jttaufa/Rattus2/BillOfMaterials.xlsx

Sheet: Prototype 1
 | METR4901 - Thesis Project
Line | Description | Qty Reqd | Supplier | Supplier Part # | Weight (g) | Order Qty | Unit Price | Currency | Total Price | Total Price (AUD) | Supplier URL
1 | 50:1 Micro Metal Gearmotor HP with Extended Motor Shaft | 2 | Littlebird | 2213 | 19 | 2 | $18.87 | AUD | $37.74 | $37.74 | http://littlebirdelectronics.com.au/products/501-micro-metal-gearmotor-hp-with-extended-motor-shaft
2 | Optical Encoder Pair Kit for Micro Metal Gearmotors, 5V | 1 | Littlebird | 2590 | 0.7 | 1 | $10.20 | AUD | $10.20 | $10.20 | http://littlebirdelectronics.com.au/products/optical-encoder-pair-kit-for-micro-metal-gearmotors-5v
3 | TB6612FNG Dual Motor Driver Carrier | 1 | Littlebird | 713 | 5 | 1 | $5.45 | AUD | $5.45 | $5.45 | http://littlebirdelectronics.com.au/products/tb6612fng-dual-motor-driver-carrier
4 | Pololu Micro Metal Gearmotor Bracket Pair - Black | 1 | Littlebird | 989 | 1.4 | 1 | $5.68 | AUD | $5.68 | $5.68 | https://www.pololu.com/product/989/specs
5 | Power HD Micro Servo HD-1900A | 1 | Littlebird | 1050 | 9 | 1 | $7.65 | AUD | $7.65 | $7.65 | http://littlebirdelectronics.com.au/products/power-hd-micro-servo-hd-1900a
6 | Arduino Micro | 1 | Pololu | 2188 | 13 | 1 | $24.95 | USD | $24.95 | $32.19 | https://www.pololu.com/product/2188
7 | Pololu Ball Caster with 1/2" Metal Ball | 1 | Pololu | 953 | 9.07 | 1 | $1.99 | USD | $1.99 | $2.57 | https://www.pololu.com/product/953
8 | Cable/Ribbon/Standard/Color Coded/10-Way | 1 | ETSG | 22-05-01' | ? | 1 | $3.35 | AUD | $3.35 | $3.35
9 | Infrared Proximity Sensor Short Range - Sharp GP2Y0A41SK0F | 2 | Pololu | 2464 | 7.2 | 2 | $10.51 | USD | $21.02 | $27.12 | https://www.pololu.com/product/2464
10 | Li-Ion 18650 Battery 7.4V, 2.6Ah LC-18650S2WR-2600 | 1 | BatterySpace | 4742 | 130 | 1 | $30.95 | USD | $30.95 | $39.93 | http://www.batteryspace.com/li-ion18650battery74v2600mah1924whbatterypackmodulewithpcbprotectionic.aspx
11 | Smart Charger (1.2A) for 7.4V Li-Ion/Polymer Rechargeable Battery Pack CH-L7412 | 1 | BatterySpace | 4208 | - | 1 | $22.95 | USD | $22.95 | $29.61 | http://www.batteryspace.com/smartcharger12afor74vli-ionpolymerrechargeablebatterypack--ullisted.aspx
12 | USR WIFI232 T Serial to Wifi Module UART to Wifi Support WPS Smart LINK | 1 | Amazon.com | - | ? | 1 | $12.76 | USD | $12.76 | $16.46 | http://www.amazon.com/Usr-wifi232-t-Power-802-11b-Price-Module/dp/B00ODV2OEW?s=pc
13 | Pololu Wheel 60x8mm Pair - Black | 1 | Pololu | 1420 | 22.68 | 1 | $7.95 | USD | $7.95 | $10.26 | https://www.pololu.com/product/1420/specs
14 | DE-SWADJ3 Adjustable Switching Voltage Regulator | 1 | RobotShop | RB-Dim-14 | 10 | 1 | $14.99 | USD | $14.99 | $19.34 | http://www.robotshop.com/en/dimension-engineering-de-swadj.html
15 | 3D Printed Material |  |  |  | - | Cost/gram -> | $0.03 | USD | $1.83 | $2.36 | http://www.dfrobot.com/index.php?route=product/product&product_id=906#.VX4BaUYnKjM
 |  |  |  | Total Upper Electronics Weight | 35.2 |  |  |  | Total (AUD) | $228.19
 |  |  |  | Total Lower Electronics Weight | 191.85
 |  |  |  | Top Platform | 20 |  |  |  | Total Weight (g) | 304
 |  |  |  | Base Platform | 28 |  |  |  | Length (mm) | 180
 |  |  |  | Motor Enclosure | 7 |  |  |  | Width (mm) | 100
 |  |  |  | Component Clip | 9 |  |  |  | Height (mm) | 75
 |  |  |  | Housing | 13

Sheet: Prototype 2
 | METR4901 - Thesis Project
Line | Description | Qty Reqd | Supplier | Supplier Part # | Weight (g) | Order Qty | Unit Price | Currency | Total Price | Total Price (AUD) | Supplier URL
1 | Connector: JST PH - Crimp Terminal Housing/ 04 Wa/ 2.00mm pitch | 2 | ETSG | 08-49-02 |  | 2 | $0.07 | AUD | $0.14 | $0.14
2 | Connector: JST PH - Crimp Terminal/Use Crimp tool K143 | 14 | ETSG | 08-50-03 |  | 14 | $0.02 | AUD | $0.28 | $0.28
3 | Connector: JST PH- Top Entry Header/ SMD/04 Way/ 2mm pitch | 2 | ETSG | 08-54-02 |  | 2 | $1.71 | AUD | $3.42 | $3.42
4 | Cables & Accessories: cable/Ribbon/standard/colour coded/10Way | 1 | ETSG | 22-05-01 |  | 1 | $3.35 | AUD | $3.35 | $3.35
5 | Connector: IDC - 06 Way female/ Class III/With Strain Relief/Harting | 2 | ETSG | 01-67-01 |  | 2 | $1.500 | AUD | $3.00 | $3.00
6 | Connector: DC power socket - 2.1mm/PCB Mounted | 1 | ETSG | 03-71-03 |  | 1 | $1.10 | AUD | $1.10 | $1.10
7 | Capacitor: Ceramic/0603/10000/10n/50V/X7R | 10 | ETSG | 64-12-01 |  | 10 | $0.01 | AUD | $0.10 | $0.10
8 | Capacitor: Ceramic/0603/100000/100n/50V/X7R | 20 | ETSG | 64-13-01 |  | 20 | $0.03 | AUD | $0.60 | $0.60
9 | Capacitor: Ceramic/0603/6800/6n8/50V/X7R | 6 | ETSG | 64-11-11 |  | 6 | $0.01 | AUD | $0.06 | $0.06
10 | Capacitor:Ceramic/0603/470000/470n/50V/X7R | 5 | ETSG | 64-13-09 |  | 5 | $0.12 | AUD | $0.60 | $0.60
11 | Resistor: 0603/100K | 6 | ETSG | 61-20-02 |  | 6 | $0.06 | AUD | $0.36 | $0.36
12 | Resistor: 0603/147K | 6 | ETSG | 61-19-06 |  | 6 | $0.06 | AUD | $0.36 | $0.36
18 | Cable/Ribbon/Standard/Color Coded/10-Way | 1 | ETSG | 22-05-01' |  | 1 | $3.35 | AUD | $3.35 | $3.35
13 | 50:1 Micro Metal Gearmotor HP with Extended Motor Shaft | 2 | Littlebird | 2213 | 9.5 | 2 | $18.87 | AUD | $37.74 | $37.74 | http://littlebirdelectronics.com.au/products/501-micro-metal-gearmotor-hp-with-extended-motor-shaft
14 | Optical Encoder Pair Kit for Micro Metal Gearmotors, 5V | 1 | Littlebird | 2590 | 0.7 | 1 | $10.20 | AUD | $10.20 | $10.20 | http://littlebirdelectronics.com.au/products/optical-encoder-pair-kit-for-micro-metal-gearmotors-5v
15 | Pololu Micro Metal Gearmotor Bracket Pair - Black | 1 | Littlebird | 989 | 1.4 | 1 | $5.68 | AUD | $5.68 | $5.68 | https://www.pololu.com/product/989/specs
16 | Power HD Micro Servo HD-1900A | 1 | Littlebird | 1050 | 9 | 1 | $7.65 | AUD | $7.65 | $7.65 | http://littlebirdelectronics.com.au/products/power-hd-micro-servo-hd-1900a
17 | Pololu Ball Caster with 1/2" Metal Ball | 1 | Pololu | 953 | 9.07 | 1 | $1.99 | USD | $1.99 | $2.57 | https://www.pololu.com/product/953
19 | Infrared Proximity Sensor Short Range - Sharp GP2Y0A41SK0F | 2 | Pololu | 2464 | 3.6 | 2 | $10.51 | AUD | $21.02 | $21.02 | https://www.pololu.com/product/2464
20 | Li-Ion 18650 Battery 7.4V, 2.6Ah LC-18650S2WR-2600 | 1 | BatterySpace | 4742 | 130 | 1 | $30.95 | USD | $30.95 | $39.93 | http://www.batteryspace.com/li-ion18650battery74v2600mah1924whbatterypackmodulewithpcbprotectionic.aspx
21 | Smart Charger (1.2A) for 7.4V Li-Ion/Polymer Rechargeable Battery Pack CH-L7412 | 1 | BatterySpace | 4208 | - | 1 | $22.95 | USD | $22.95 | $29.61 | http://www.batteryspace.com/smartcharger12afor74vli-ionpolymerrechargeablebatterypack--ullisted.aspx
22 | USR WIFI232 T Serial to Wifi Module UART to Wifi Support WPS Smart LINK | 1 | Amazon.com |  | ? | 1 | $12.76 | USD | $12.76 | $16.46 | http://www.amazon.com/Usr-wifi232-t-Power-802-11b-Price-Module/dp/B00ODV2OEW
23 | Pololu Wheel 60x8mm Pair - Black | 1 | Pololu | 1420 | 22.68 | 1 | $7.95 | USD | $7.95 | $10.26 | https://www.pololu.com/product/1420/specs
24 | Printed Circuit Board | 1 | PCBZone | - | see below | 1 | $38.46 | AUD | $38.46 | $38.46 | http://www.pcbzone.net/user/QuoteArea.aspx?type=cal
25 | ATUC256L3U AVR32 UC3 Microcontroller | 1 | RS Components | 761-7719 | 0.3 | 1 | $14.55 | AUD | $14.55 | $14.55 | http://au.rs-online.com/web/p/microcontrollers/7617719/
26 | LSM6DS0 IMU | 1 | Mouser Electronics | 511-LSM6DS0TR |  | 1 | $7.68 | AUD | $7.68 | $7.68 | http://www.mouser.com/ProductDetail/STMicroelectronics/LSM6DS0TR/?qs=4b8myOmUP%252buQnYcHb5DBNA%3D%3D
27 | TB6612FNG Dual Motor Driver | 1 | Mouser Electronics | 757-TB6612FNGOC8EL | 0.14 | 1 | $4.13 | AUD | $4.13 | $4.13 | https://www.pololu.com/product/713/specs
28 | AP6503SP-13 Buck Converter | 1 | RS Components | 822-8859 |  | 1 | $1.20 | AUD | $1.20 | $1.20 | http://au.rs-online.com/web/p/dc-dc-converters/8228859/
29 | Texas Instruments LM3940IMP-3.3/NOPB Linar Regulator | 1 | RS Components | 536-1546 |  | 1 | $2.01 | AUD | $2.01 | $2.01 | http://au.rs-online.com/web/p/low-dropout-voltage-regulators/5361546/?searchTerm=536-1546
30 | Fairchild FDN306P P-channel MOSFET Transistor | 1 | RS Components | 671-0416 |  | 1 | $0.75 | AUD | $0.75 | $0.75 | http://au.rs-online.com/web/p/mosfet-transistors/6710416/?searchTerm=671-0416
31 | Littelfuse 0.5A Surface Mount Resettable Fuse, 13.2 V dc | 1 | RS Components | 787-4202 |  | 1 | $0.49 | AUD | $0.49 | $0.49 | http://au.rs-online.com/web/p/resettable-surface-mount-fuses/7874202/?searchTerm=787-4202
32 | USB Connectors MICRO B RECEPT RA SMT BTTM MNT | 1 | Mouser Electronics | 685-0965 |  | 1 | $1.28 | AUD | $1.28 | $1.28 | http://au.mouser.com/ProductDetail/Hirose-Electric/ZX62-B-5PA11/
33 | 3D Printed Material | 1 | UQ | - |  | Cost/gram -> | $0.03 | USD | $3.91 | $5.05
 |  |  | Weights (g) | Total PCB (with components) | 25 |  |  |  | Total | $273.41
 |  |  |  | Total Bottom Electronics | 182.35
 |  |  |  | Other Upper Electronics | 3.6 |  |  |  | Total Weight (g) | 347.95
 |  |  |  | Top Platform | 44
 |  |  |  | Base Platform | 33 |  |  |  | Length | 145.5mm
 |  |  |  | Motor Enclosure | 9 |  |  |  | Width
 |  |  |  | Housing | 51 |  |  |  | Height

Sheet: Currencies
Currency | Exchange Rate | Note
AUD | 1 | AUD Prices quoted EXCLUDE GST
AUD-incGST | 0.9090909091 | AUD Prices quoted INCLUDE GST
USD | 1.283449913 | 3 month average up to 23 May
