jttaufa/Rattus2/Altium_Schematic/Rattus02/iRat_2.1.step

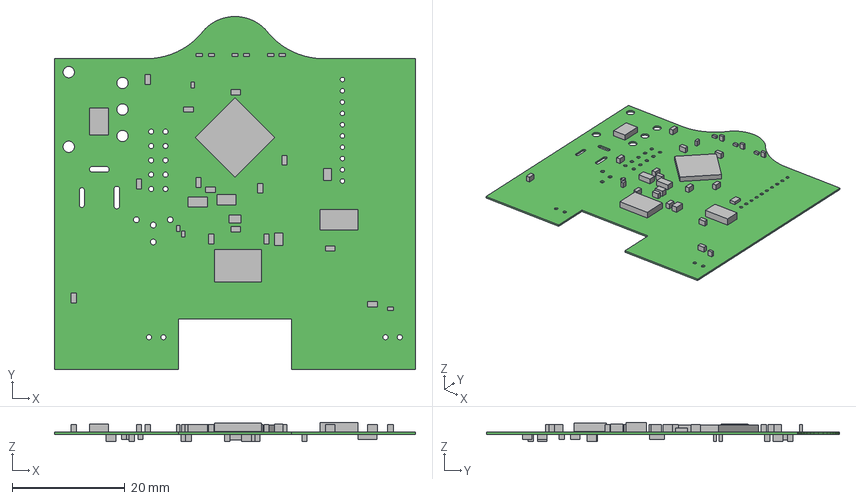
[picture p1: CAD file, 2015-06-15]
Altium_Schematic/Rattus02/iRat_2.1.step
64.0 x 62.6 x 3.40 mm
Board
Extruded x 48
