jttaufa/Rattus2/(list of files, cad)

Other CAD files:
Altium_Schematic/Rattus02/Part1.ipt
Altium_Schematic/Rattus02/iRat_2.1.DWG
Prototype 1/Assembly2.iam
Prototype 1/Base_Platform_Extended_Model2.1.ipt
Prototype 1/Component_Clip_A.ipt
Prototype 1/Models/Arduino_Micro.ipt
Prototype 1/Models/Caster.ipt
Prototype 1/Models/HD-1900A_Servo.ipt
Prototype 1/Models/Motor_Bracket.ipt
Prototype 1/Models/Motors.ipt
Prototype 1/Models/Pivot_Rod.ipt
Prototype 1/Models/Power_Socket.ipt
Prototype 1/Models/Power_Switch.ipt
Prototype 1/Models/VReg.ipt
Prototype 1/Models/Wheel.ipt
Prototype 1/Motor_Enclosure.ipt
Prototype 1/Top_Platform_Extended.ipt
