jttaufa/Rattus2/Altium_Schematic/Rattus02/iRat_2.0.PDF

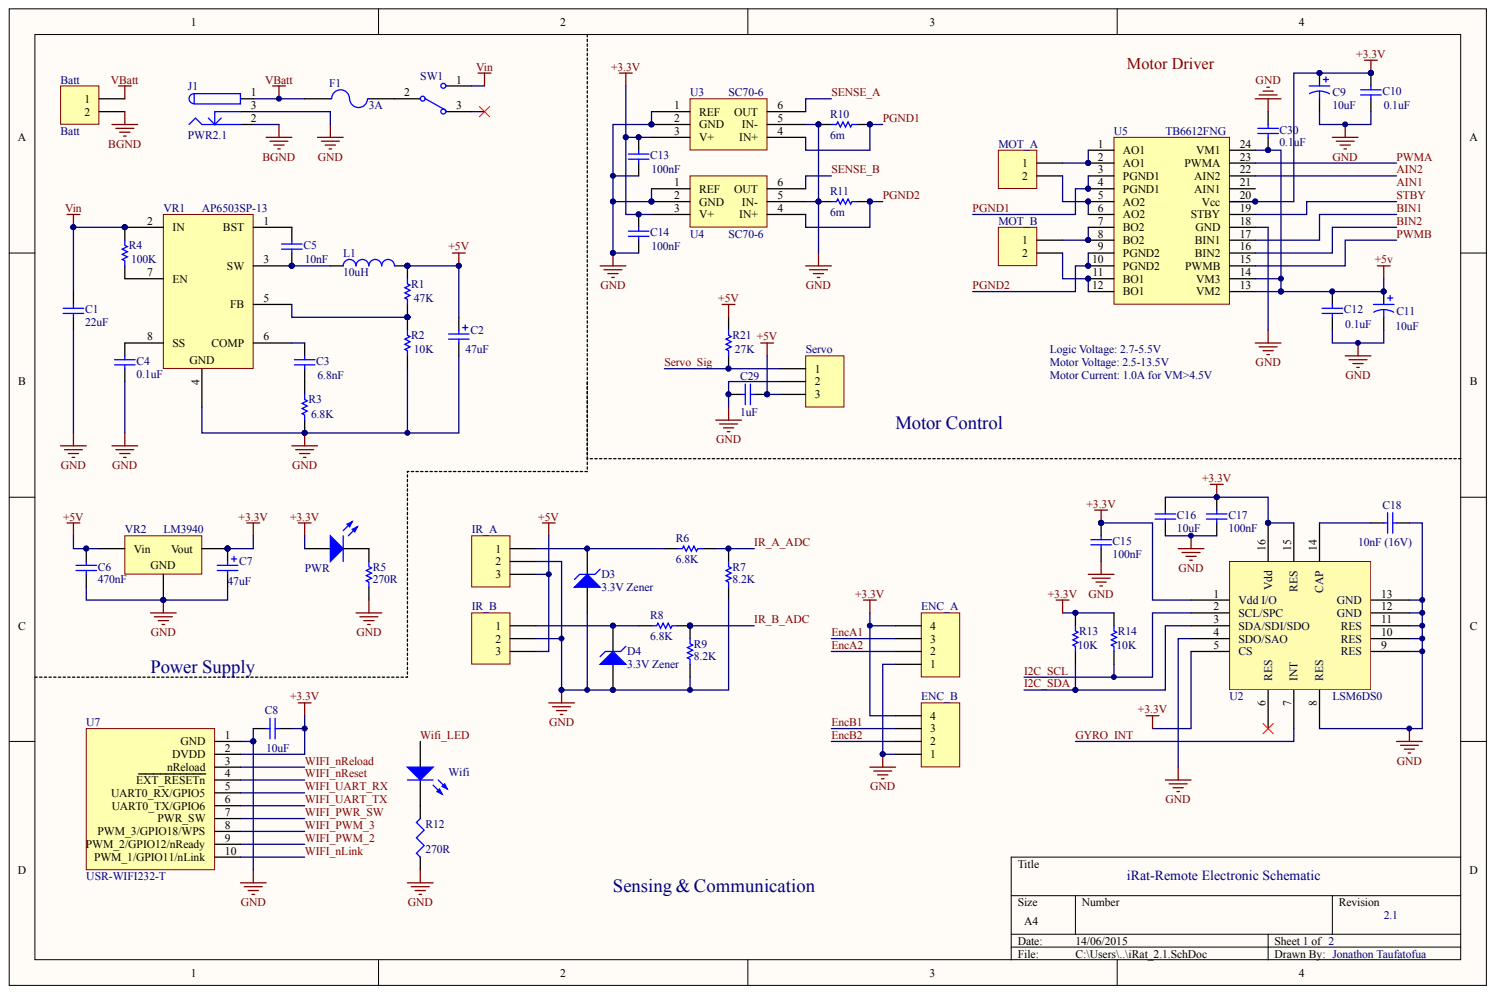
[picture p2: page 1]

Logic Voltage: 2.7-5.5V
Motor Voltage: 2.5-13.5V
Motor Current: 1.0A for VM>4.5V

iRat-Remote Electronic Schematic

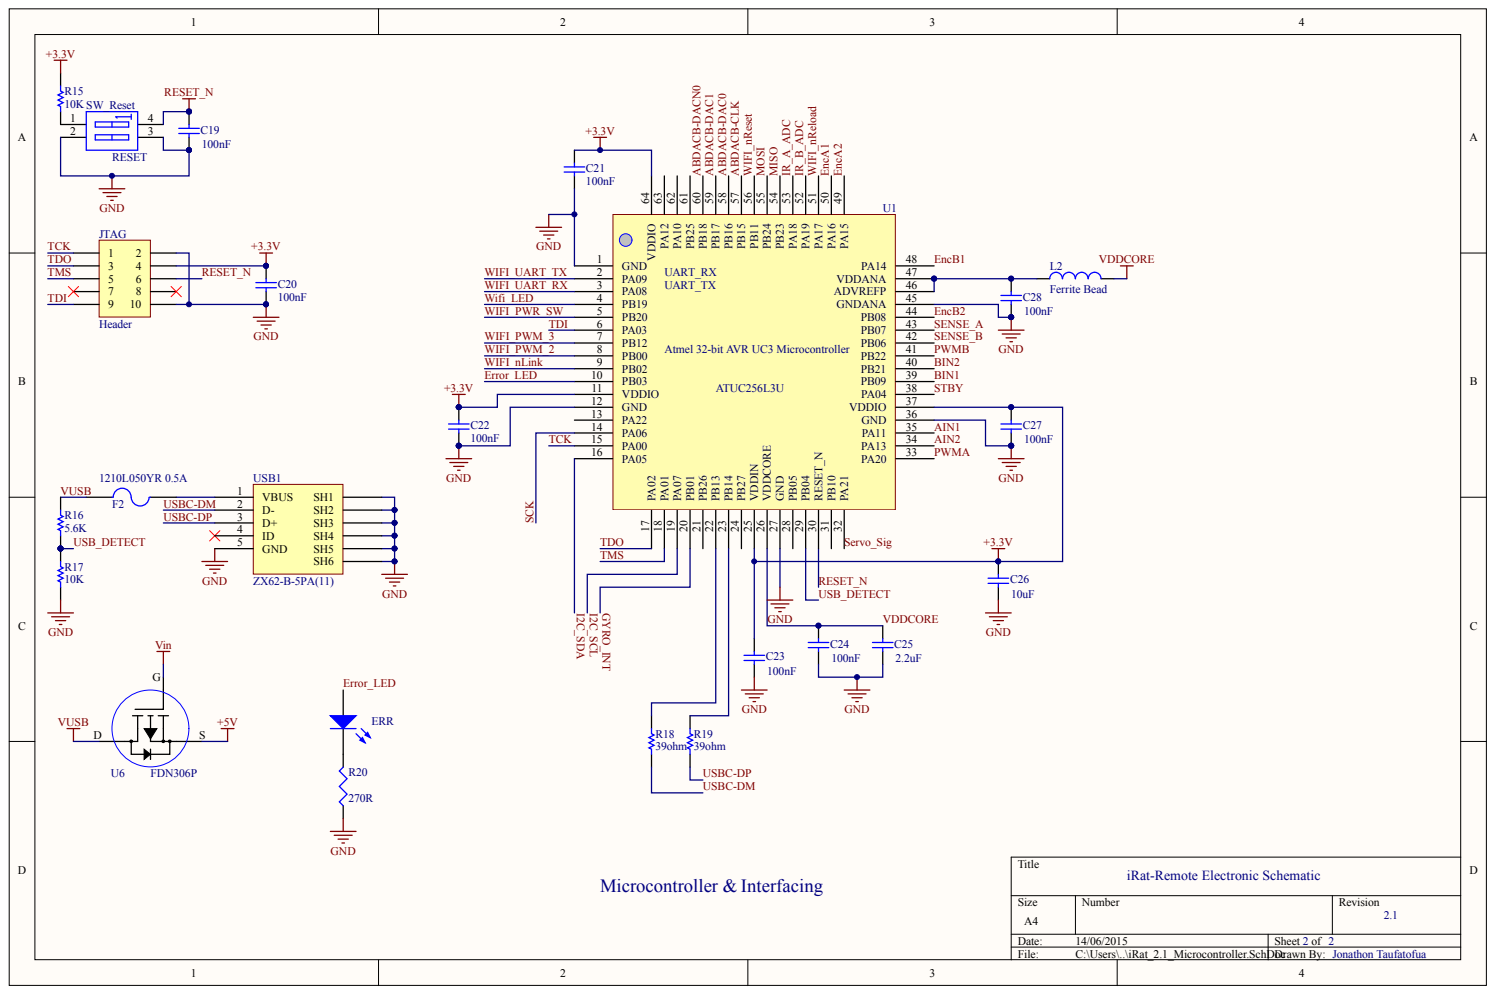
[picture p3: page 2]

C22 | GND 12 PA22 13 PA06 14 PA00 15 PA05 16

AIN1 AIN2

TCK

iRat-Remote Electronic Schematic

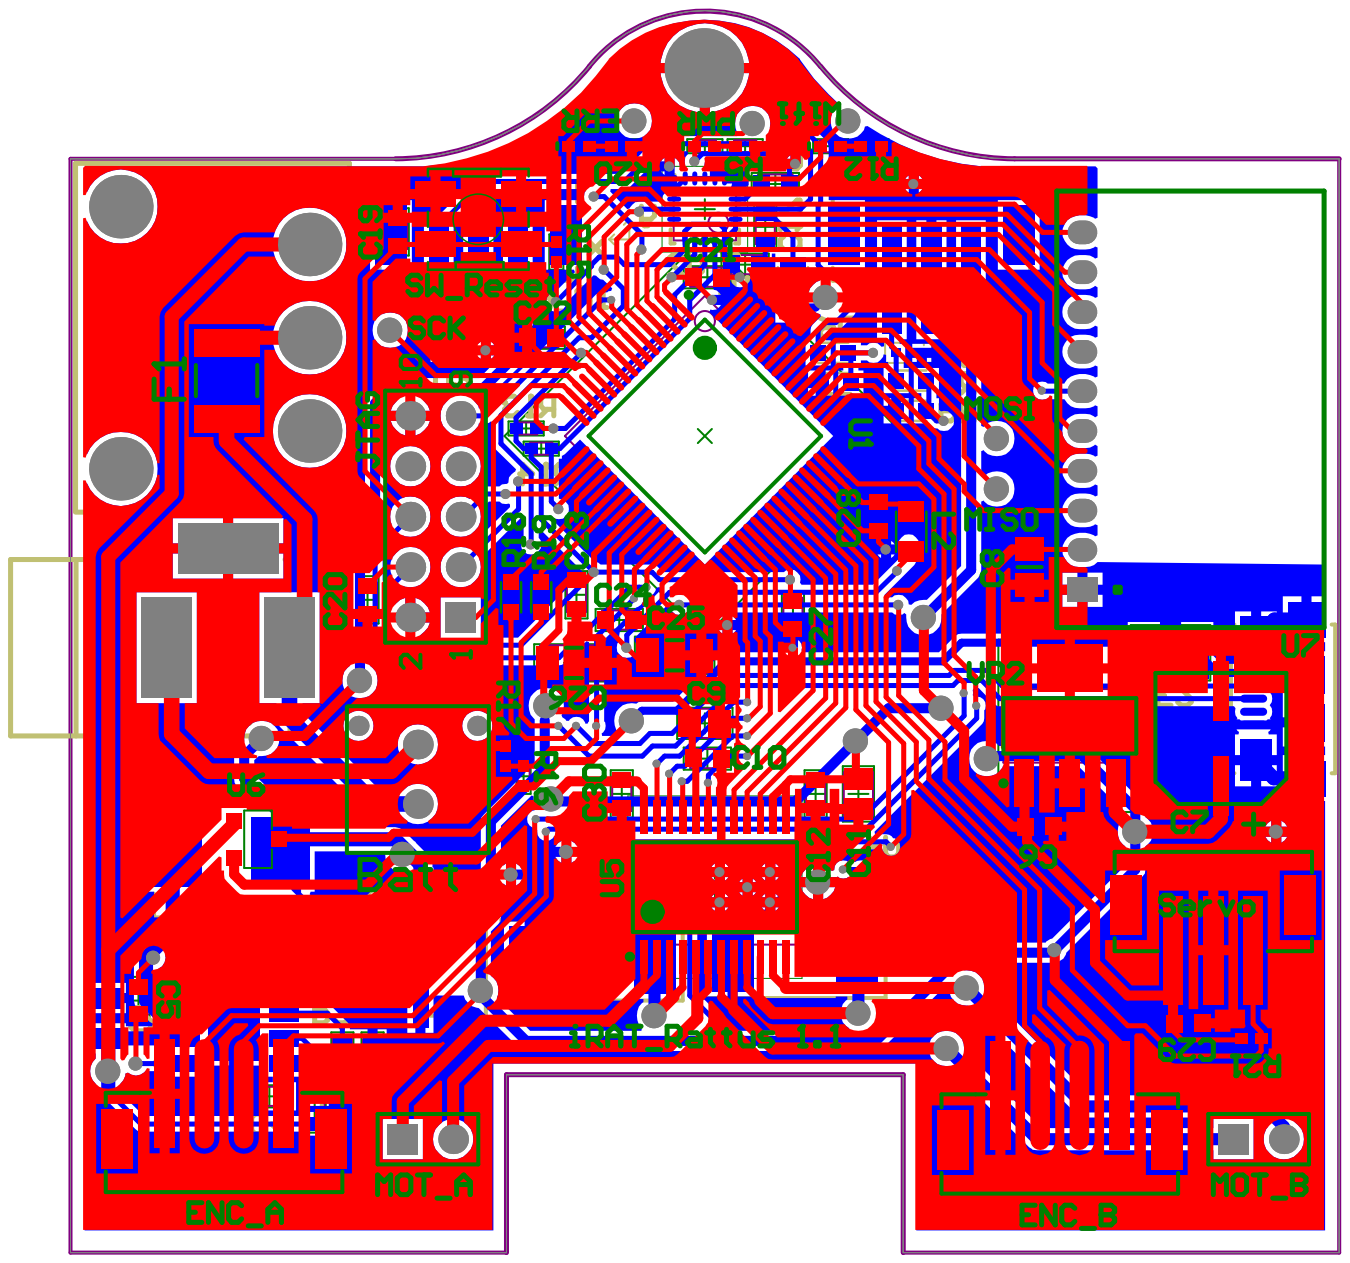
[picture p4: page 3]
