jttaufa/Rattus2/(list of files, drawings)

Other design files:
Altium_Schematic/Rattus01/iRat.PrjPcb
Altium_Schematic/Rattus01/iRat.SchDoc
Altium_Schematic/Rattus01/iRat.SchLib
Altium_Schematic/Rattus02/iRat.SchDoc
Altium_Schematic/Rattus02/iRat_2.0.PcbDoc
Altium_Schematic/Rattus02/iRat_2.0.PcbLib
Altium_Schematic/Rattus02/iRat_2.0.PrjPcb
Altium_Schematic/Rattus02/iRat_2.0.SchDoc
Altium_Schematic/Rattus02/iRat_2.0.SchLib
Altium_Schematic/Rattus02/iRat_2.1.PcbDoc
Altium_Schematic/Rattus02/iRat_2.1.SchDoc
Altium_Schematic/Rattus02/iRat_2.1_Comm.SchDoc
Altium_Schematic/Rattus02/iRat_2.1_Microcontroller.SchDoc
Altium_Schematic/Rattus02/Sheet1.SchDoc
Altium_Schematic/Rattus02/Sheet2.SchDoc
